petrstehlik/biometrics-hand-detector/README.md

# Capturing of 2D Hand Geometry With Line Camera

The aim of the project is to assemble a mechanical device and create software for acquiring 2D hand geometry using a line camera.

More info in the [technical report](https://github.com/petrstehlik/biometrics-hand-detector/raw/master/docs/doc.pdf).
