petrstehlik/biometrics-hand-detector/rail-control/capture.py

#!/usb/bin/env python
"""
BIO: Capture hand image via a connected line camera
"""
import tel_commander as light
import serial as serial
import time
import logging
import shutil
import subprocess
import os
import sys

if os.geteuid() != 0:
    # Check for root privileges
    sys.write(STDERR, "Capturing requires root privileges.")
    sys.exit(1)

logging.basicConfig(level = logging.DEBUG)
log = logging.getLogger("CAPTURE")

log.info("Setting up serial")
ser = serial.Serial('/dev/ttyUSB0', 115200)

if __name__ == "__main__":
    # Send rail for 10s left
    log.info("Sending rail left for 10 s")
    ser.write("R10000")

    # Set light intensity to 1200 mA
    log.info("Set light intensity to 1200 mA")
    light.cmd("IY E 1400")

    # Turn light on
    log.info("Turning light on")
    light.cmd("LC A 1")

    # Here should be runing of the grabbing binary
    log.debug("Should grab image")
    log.info("Waiting for movement finish")
    subprocess.call("../src/capture 700 500", shell=True)

    shutil.copyfile("./result.jpg", "/var/www/html/bio/result_"+str(int(time.time()))+".jpg")


    log.info("Turning off light")
    light.cmd("LC A 0")

    log.info("Sending rail back right for 10 s")
    ser.write("L10000")
