petrstehlik/biometrics-hand-detector/(commit log)

2017-11-08 Add rail control script
2017-11-08 Repolished constants in rail control
2017-11-15 Add slow PWM Arduino code
2017-11-15 Add Arduino schematics and rail control paragraphs
2017-11-15 Add serial communication to Arduino and super fine PWM
2017-11-16 Remove PWM pin setup from GPIO control
2017-11-16 Add settings to camera setup
2017-11-16 capture.cpp: make camera attributes parametrized
    Usage:
    ./capture <exposureTime> <acquisitionRate>
